vanillashake17/epp2-updated/(commit log)

2026-03-18 Move robotlib.ino to sensor_miniproject_template folder
2026-03-18 Implement remote motor controls and speed adjustments in Python UI
2026-03-18 Implement COMMAND_MOVE handler with timed motor control on Arduino
2026-03-20 implement feature that allows code to run when components are not attached
2026-03-20 update sensor template ino
2026-03-20 revert to previous colour pin configuration
    [sensor_miniproject_template.ino]
2026-03-22 implement emergency button 'x' that stops robot when in movement
2026-03-23 integrate robot arm with timer 5 and flatten code2 into code1
2026-03-23 fix slam child process imports for pyrplidar and lidar
2026-03-29 add arm commands
2026-03-30 add matplotlib slam client and lidar forwarder for offloaded slam
2026-03-30 modify lidar_forward code
2026-04-01 change servo input (allow b90 instead of b090)
2026-04-03 Add colour sensor UML sequence diagrams
2026-04-03 Add camera sensor UML sequence diagrams
2026-04-03 Add motor UML sequence diagrams
2026-04-03 Add robot arm UML sequence diagram
2026-04-03 fix relay.py description in readme to reflect it is an embedded module
2026-04-03 Add lidar UML sequence diagrams
2026-04-03 fix(diagrams): add lidar_drv -> settings arrow to software architecture
2026-04-03 fix(diagrams): remove RESP_OK from estop flow
2026-04-03 fix(diagrams): add Arduino-side E-Stop gate to motor flow
2026-04-03 doc(diagrams): update robot arm description to include speed command
2026-04-03 fix(diagrams): correct E-Stop command flow diagram and update state handling
2026-04-06 flip elbow and gripper pins
    [pi_sensor.py, sensor_miniproject_template.ino]
2026-04-06 add servo testing folder
2026-04-06 servo changes
2026-04-06 change servo min max values
2026-04-06 calibrate servo
2026-04-06 print colour every 1s in both driving modes
2026-04-07 change servo min max, remove autoprint colour
2026-04-07 rotate camera image 90deg ccw, and changed elbow values
2026-04-07 auto print colour every 6s, modify second terminal to print response packts from colour
2026-04-07 remove printing of colour values in second terminal
2026-04-07 enable auto colour toggle, change elbow pin to 33
2026-04-07 deleted servotest, fix second terminal print errors
    [pi_sensor.py, sensor_miniproject_template.ino]
2026-04-07 fixed bugs, removed dead code
    [pi_sensor.py, sensor_miniproject_template.ino, serial_driver.h]
2026-04-08 change raw drive mode, auto colour printing
2026-04-08 Revert "revert some changes"
    This reverts commit 9c99ff6691c372d6cb0f3bcb20e4dc1e09273527.
    [pi_sensor.py, sensor_miniproject_template.ino]
2026-04-08 Revert "change raw drive mode, auto colour printing"
    This reverts commit ba3748202a58d5180a322404b9e66edd54226491.
    [pi_sensor.py]
2026-04-09 second terminal prints colour
2026-04-11 camera works in rawdrivemode
2026-04-11 add print colour toggle and make raw drive mode default
2026-04-11 add colour print toggle to second terminal
2026-04-11 change colour sensor interval to 5s, second terminal prints colour
2026-04-12 change hole_width
2026-04-12 calibrate sensor
2026-04-12 camera adjusstments
2026-04-12 servo limits change
2026-04-12 servo position moved
2026-04-13 [beta] lidar optimisations
2026-04-14 remove lidar optimisation changes, change home position
2026-04-17 change servo limits, change colour sensor interval
2026-04-19 added arduino and arm command
2026-04-20 added camera, color sensor and arduino diagram
2026-04-20 format sensor miniproject folder
2026-04-20 refactor sensor miniproject ino
2026-04-21 rename sensor minitemplate to alex_firmware
2026-04-21 simply switch statements
2026-04-22 remove arm commands from pi sensor
